flightsketch/board/FS-Mini-Back.pdf

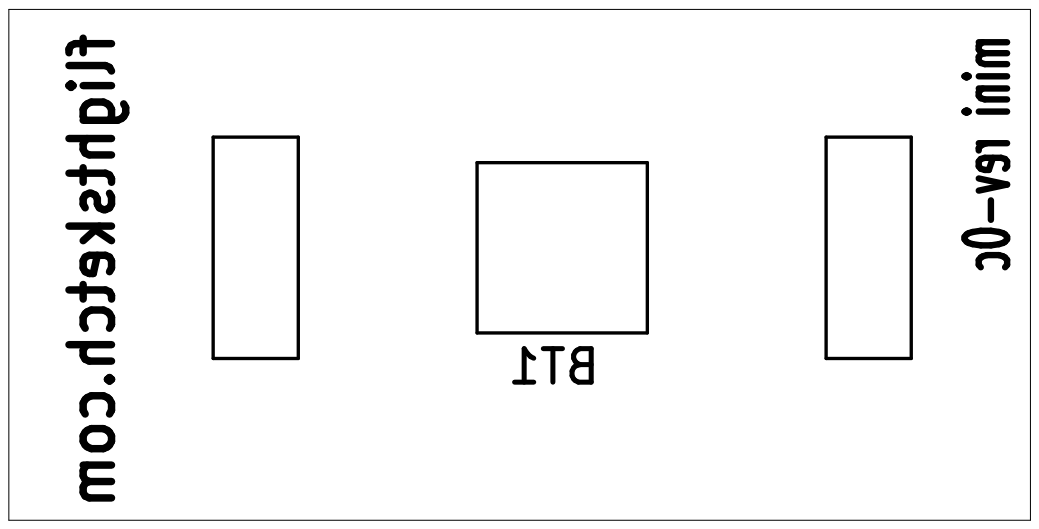
[picture p1: page 1]
