flightsketch/board/FS-Mini-Front.pdf

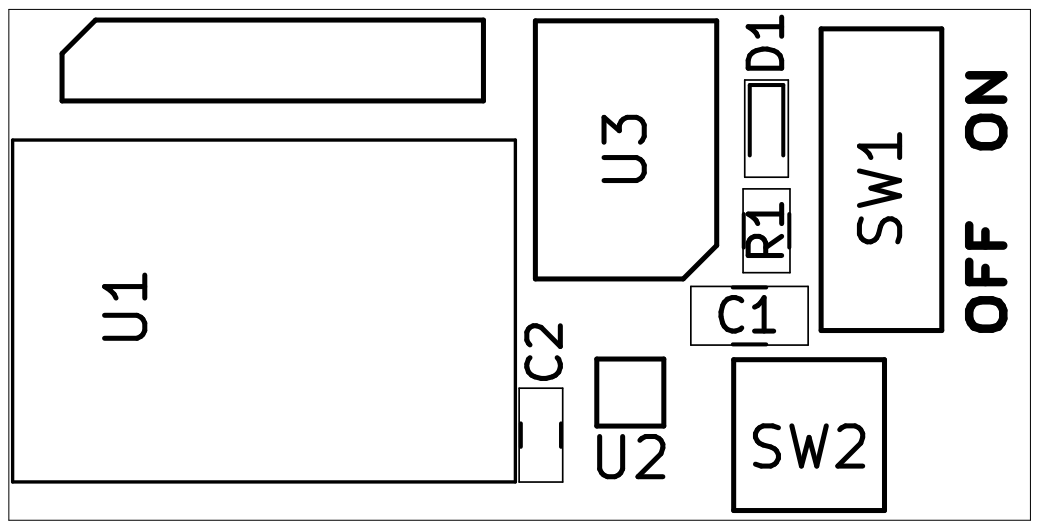
[picture p2: page 1]
