flightsketch/board/(list of files, drawings)

Other design files:
flightSketch-standard.dsn
