flightsketch/board/(threads)

Thread 1 (2019-01-25):

Bmp280 brownout

gtg738w, 2019-01-25:
Baro resets on power bus dips. Need more capacitance on bus.

gtg738w, 2019-02-13:
Added 2x 22uf caps & switching to bmp388

Closed 2019-02-13.

Thread 2 (2019-01-25):

Remove external batt

gtg738w, 2019-01-25:
Very good life on coin cell, probably don't need Lipo compatibility.

gtg738w, 2019-02-13:
Fixed in mini beta2

Closed 2019-02-13.

Thread 4 (2019-02-13):

Add vias to strengthen cell holder pads

gtg738w, 2019-02-13:

gtg738w, 2019-02-16:
fixed also switched to 1225 glider holder

Closed 2019-02-16.
