flightsketch/board/(commit log)

2019-01-13 fixed batt holder polarity. Adds voltage sense
    [_saved_flightSketch-standard.sch, flightSketch-standard.kicad_pcb, flightSketch-standard.sch]
2019-02-17 change battery holder to 1225 glider. Increase mounting slot size
    [_saved_flightSketch-standard.sch, flightSketch-standard.kicad_pcb, flightSketch-standard.sch]
2019-09-04 stencil update
    [_saved_flightSketch-standard.sch, flightSketch-standard.kicad_pcb, flightSketch-standard.sch]
2019-09-07 fanstel mini wip
    [flightSketch-standard.dsn, flightSketch-standard.kicad_pcb, flightSketch-standard.sch]
2019-09-12 rev-0c sch save
    [_saved_flightSketch-standard.sch, flightSketch-standard.sch]
2019-09-17 revC stencil update
    [flightSketch-standard.kicad_pcb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]
2019-09-20 mfg files
    [FSMini_BoM.csv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]
2019-09-29 update for stencil
    [flightSketch-standard-F.Paste.gbr]
2019-10-09 fixes vdd on flash, now switched power
    [flightSketch-standard.dsn, flightSketch-standard.kicad_pcb, flightSketch-standard.sch]
2019-10-09 rev 0f
    [flightSketch-standard.kicad_pcb]
2019-10-22 rev 0f mfg updates
    [FSMini_BoM.csv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]
